SebyR/SmartMed-Dispenser-V2/Poze/20210726_211505.jpg

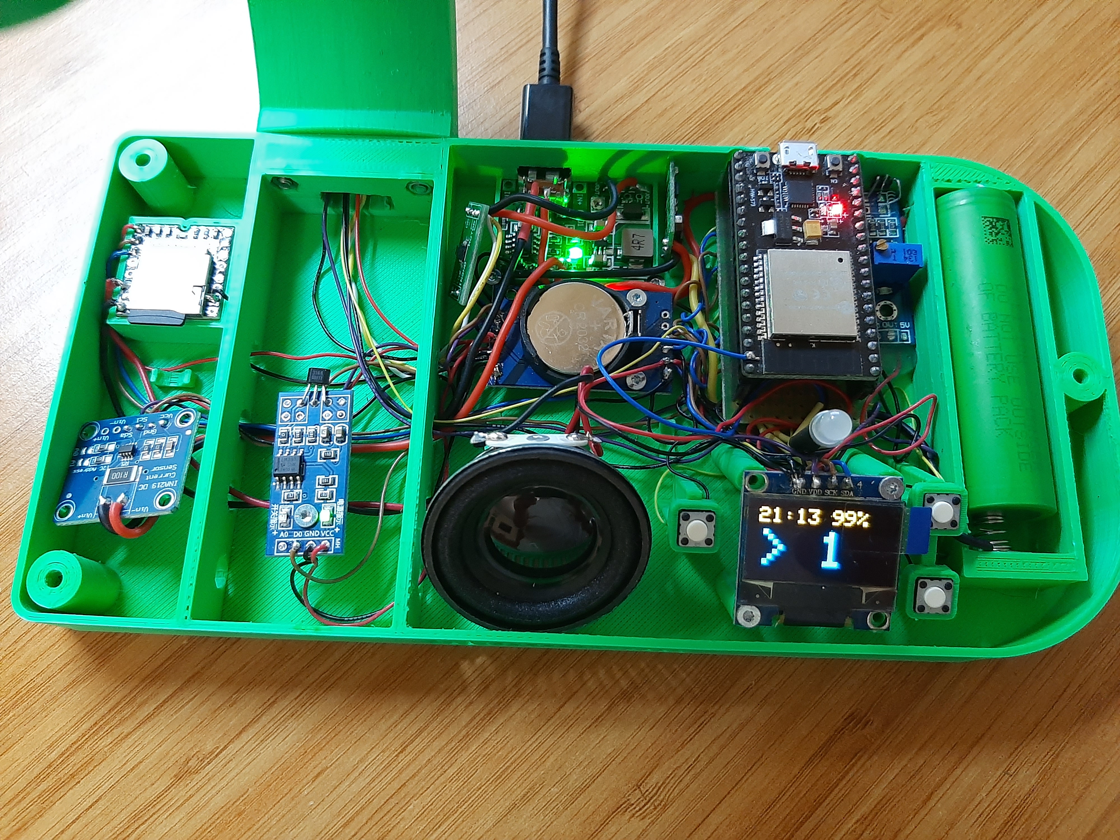
Poze/20210726_211505.jpg
