SebyR/SmartMed-Dispenser-V2/Poze/a0e3332b-9459-4f83-ae07-1069cf7968dd.jpg

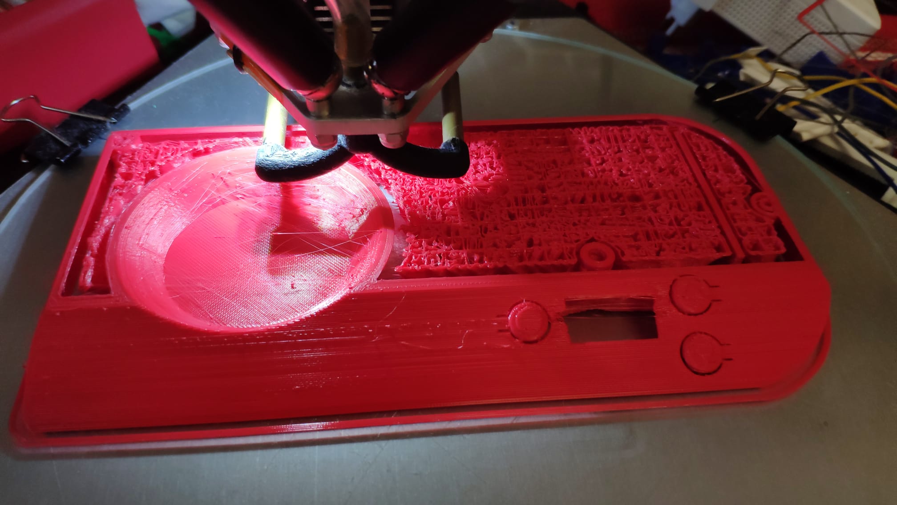
Poze/a0e3332b-9459-4f83-ae07-1069cf7968dd.jpg
