SebyR/SmartMed-Dispenser-V2/README.md

# SmartMed-Dispenser-V2
Dispozitiv inteligent programabil pentru organizarea și dozarea medicației zilnice a persoanelor în vârstă
