SebyR/SmartMed-Dispenser-V2/Poze/SmartMed_Dispenser_V2.1 v4.png

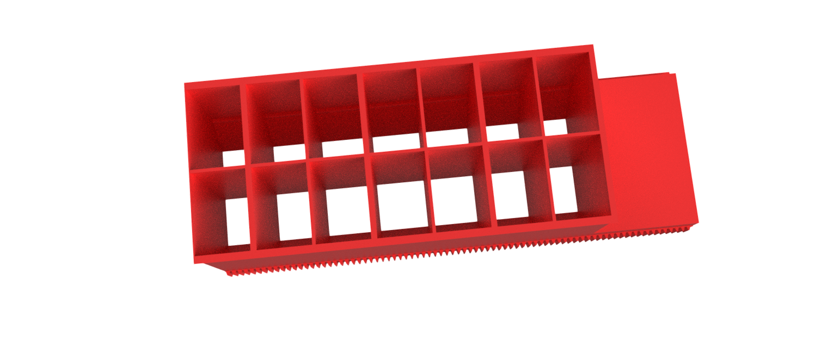
Poze/SmartMed_Dispenser_V2.1 v4.png
