SebyR/SmartMed-Dispenser-V2/STL-uri/Capac_pinion_up.stl

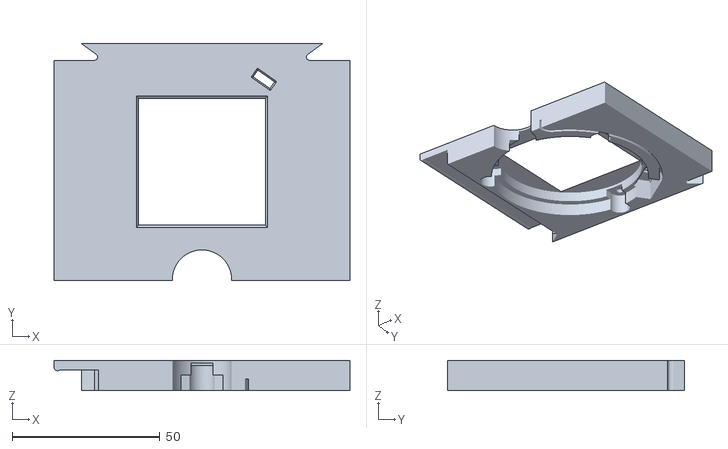
[picture p20: CAD file, 2021-07-26]
STL-uri/Capac_pinion_up.stl
100.0 x 79.9 x 10.2
