SebyR/SmartMed-Dispenser-V2/STL-uri/Capac.stl

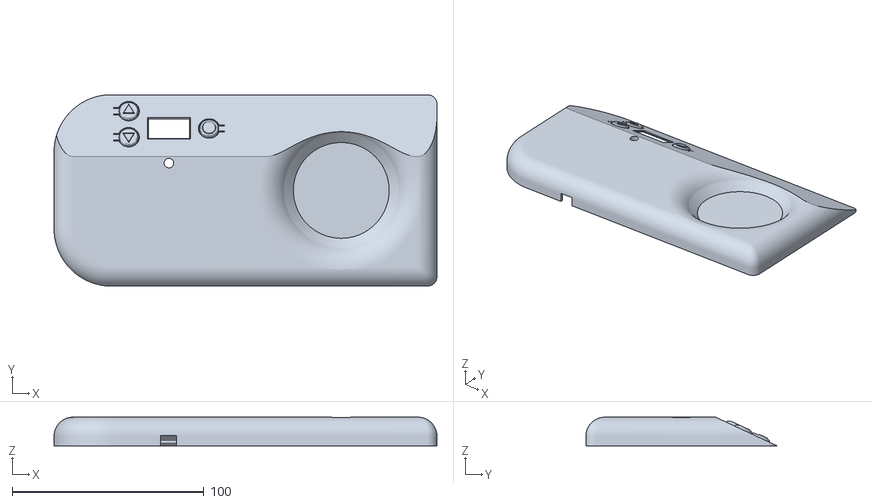
[picture p21: CAD file, 2021-07-26]
STL-uri/Capac.stl
200.0 x 99.9 x 15.0
