SebyR/SmartMed-Dispenser-V2/STL-uri/Ghidaj_fata.stl

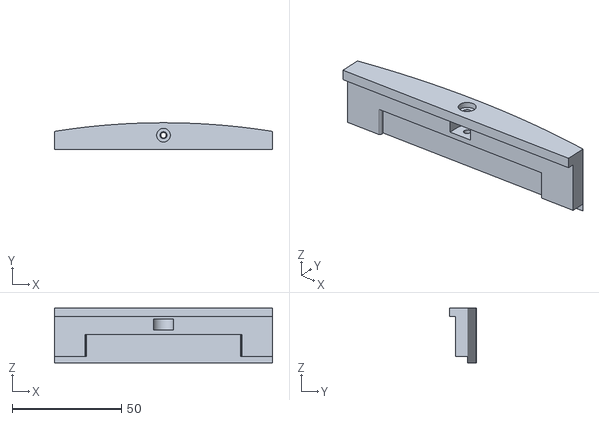
[picture p22: CAD file, 2021-07-26]
STL-uri/Ghidaj_fata.stl
100.0 x 12.2 x 25.0
