SebyR/SmartMed-Dispenser-V2/STL-uri/Brat.stl

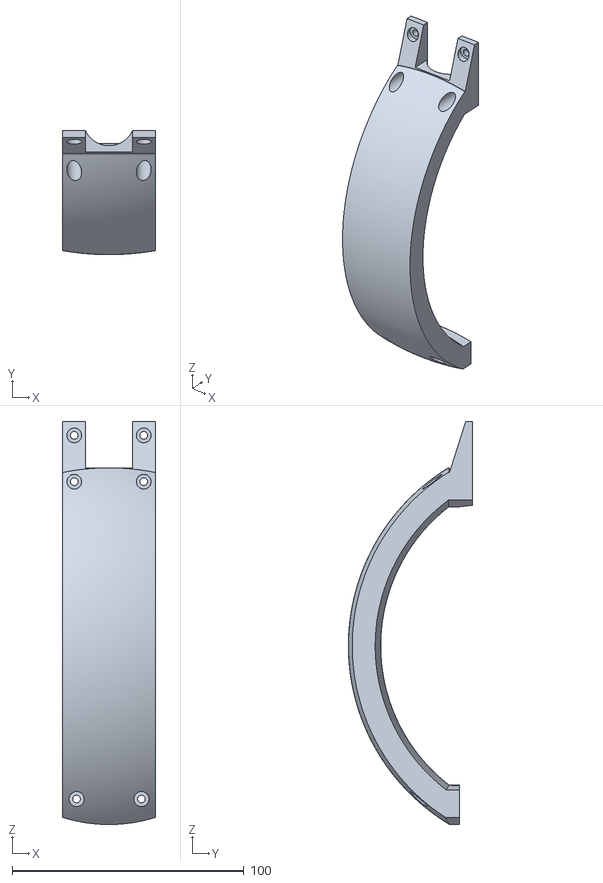
[picture p23: CAD file, 2021-07-26]
STL-uri/Brat.stl
40.0 x 53.7 x 174.0
