SebyR/SmartMed-Dispenser-V2/STL-uri/Capac_pinion_dn.stl

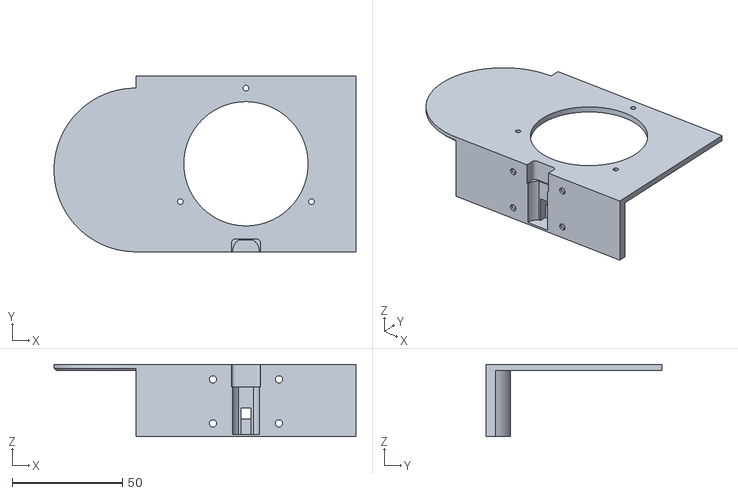
[picture p24: CAD file, 2021-07-26]
STL-uri/Capac_pinion_dn.stl
137.2 x 79.8 x 32.8
