SebyR/SmartMed-Dispenser-V2/STL-uri/Baza_disp.stl

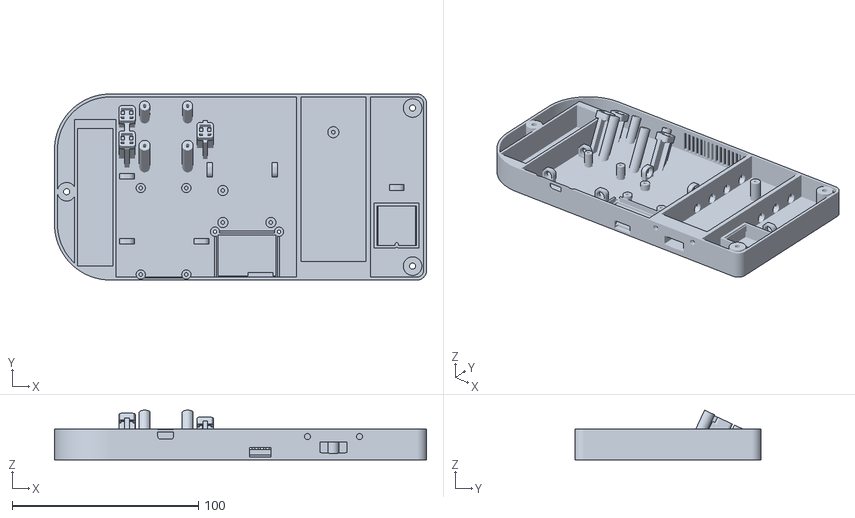
[picture p25: CAD file, 2021-07-26]
STL-uri/Baza_disp.stl
200.0 x 100.0 x 26.7
