SebyR/SmartMed-Dispenser-V2/STL-uri/Palnie.stl

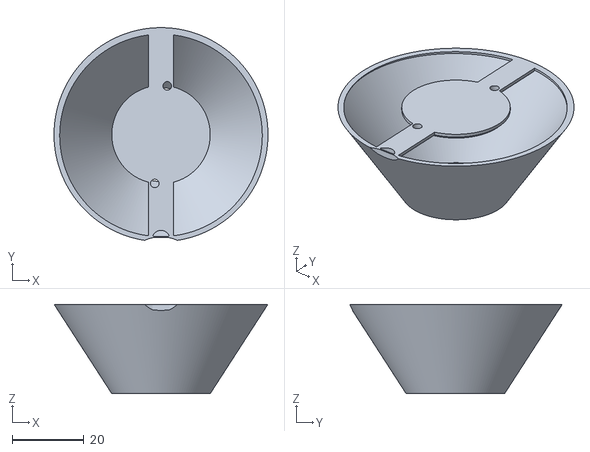
[picture p26: CAD file, 2021-07-26]
STL-uri/Palnie.stl
59.8 x 59.4 x 25.0
