SebyR/SmartMed-Dispenser-V2/STL-uri/Capac_motor.stl

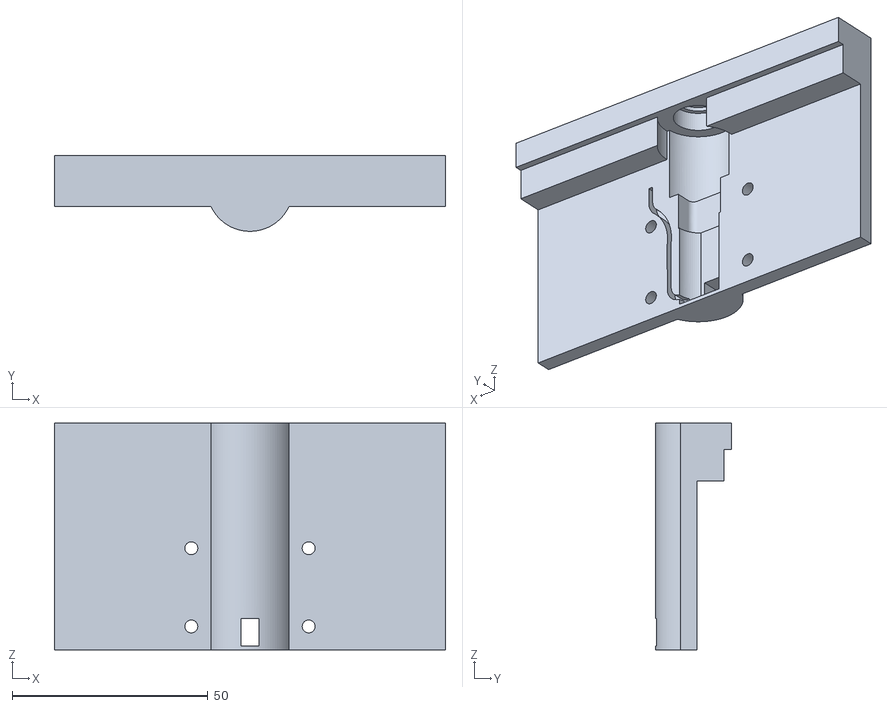
[picture p27: CAD file, 2021-07-26]
STL-uri/Capac_motor.stl
100.0 x 19.3 x 58.0
