SebyR/SmartMed-Dispenser-V2/STL-uri/Cutie_4_interv.stl

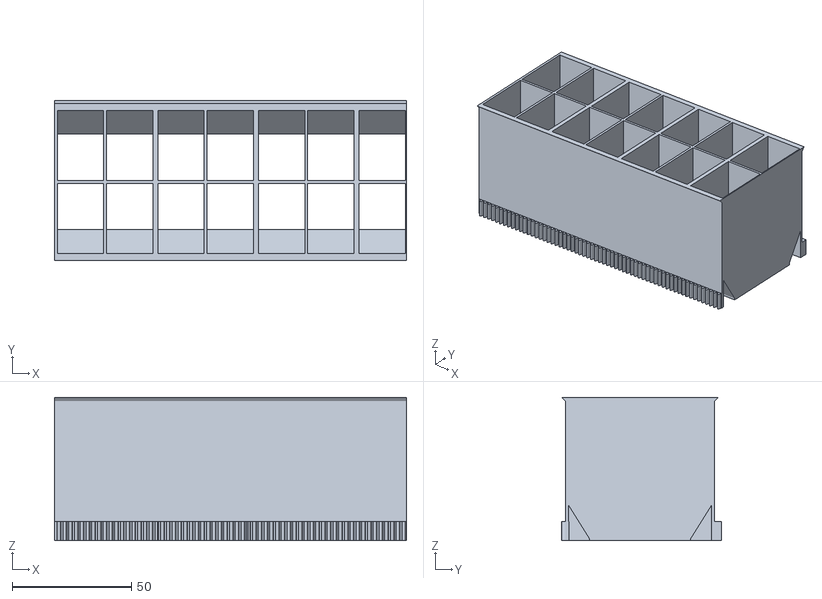
[picture p28: CAD file, 2021-07-26]
STL-uri/Cutie_4_interv.stl
147.4 x 67.2 x 60.0
