SebyR/SmartMed-Dispenser-V2/STL-uri/Capac_cutie.stl

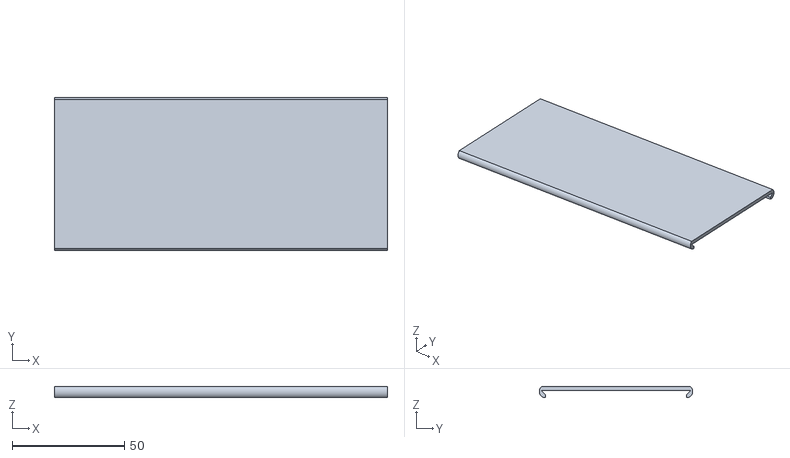
[picture p29: CAD file, 2021-07-26]
STL-uri/Capac_cutie.stl
148.3 x 68.3 x 4.89
