SebyR/SmartMed-Dispenser-V2/STL-uri/Mont_abs_pos.stl

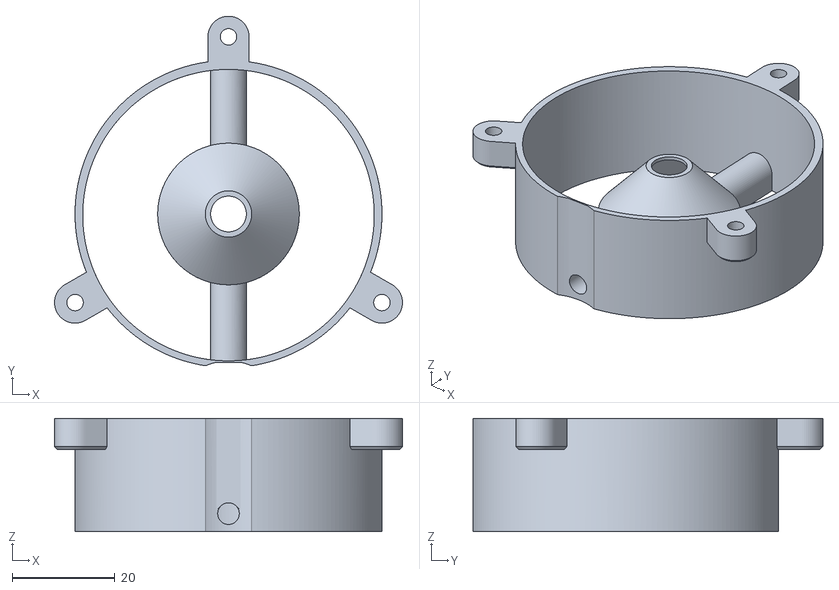
[picture p30: CAD file, 2021-07-26]
STL-uri/Mont_abs_pos.stl
67.6 x 67.9 x 22.0
