SebyR/SmartMed-Dispenser-V2/STL-uri/Suport_2.stl

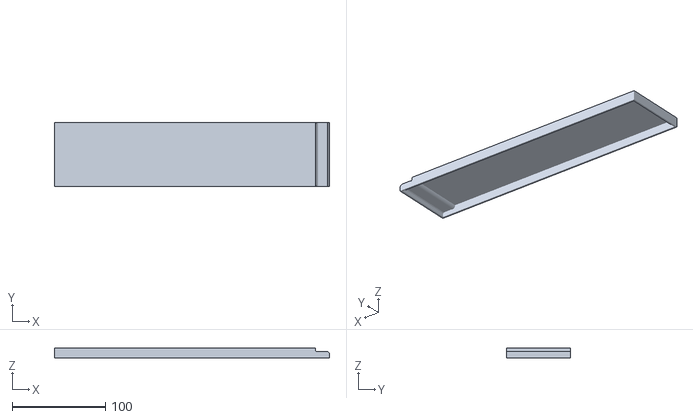
[picture p31: CAD file, 2021-07-26]
STL-uri/Suport_2.stl
294.9 x 69.0 x 10.2
