SebyR/SmartMed-Dispenser-V2/STL-uri/Bolt_magnet.stl

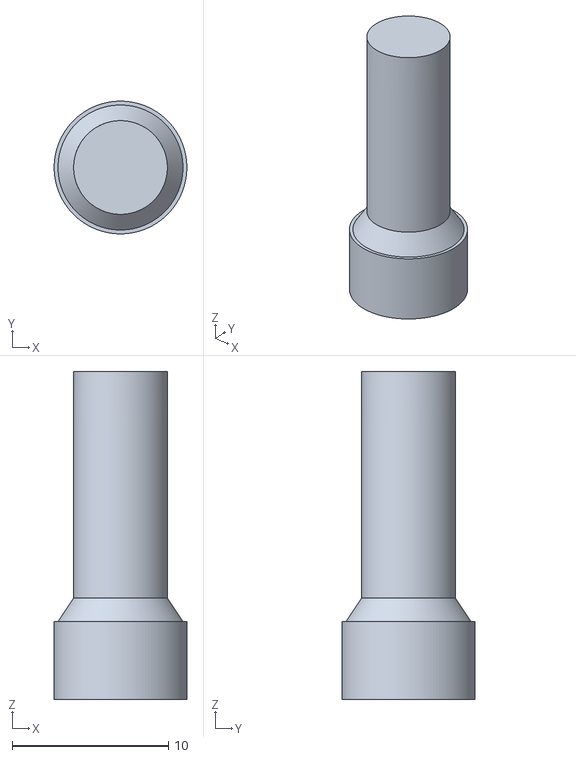
[picture p32: CAD file, 2021-07-26]
STL-uri/Bolt_magnet.stl
8.50 x 8.50 x 21.0
