SebyR/SmartMed-Dispenser-V2/STL-uri/Capac_cutie (1).stl

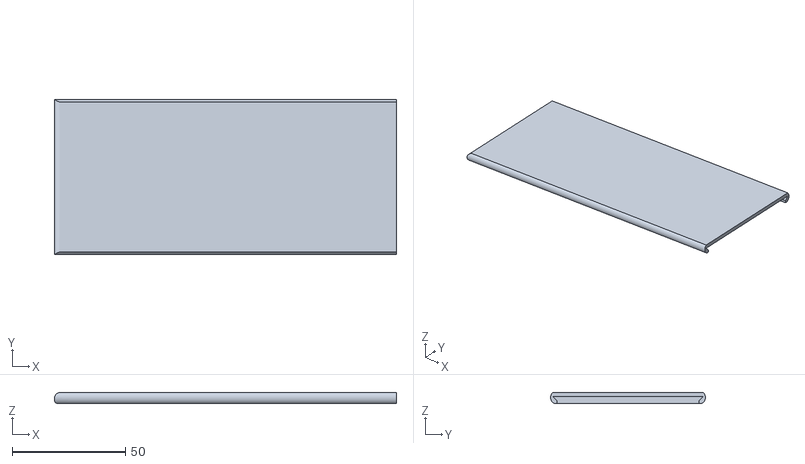
[picture p33: CAD file, 2021-07-26, an earlier design]
STL-uri/Capac_cutie (1).stl
150.8 x 68.3 x 4.89
