SebyR/SmartMed-Dispenser-V2/STL-uri/Cutie_4_interv (1).stl

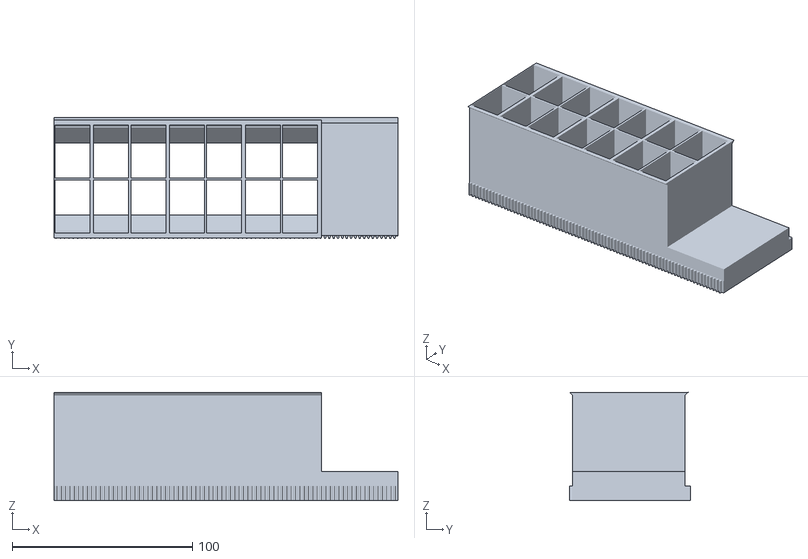
[picture p34: CAD file, 2021-07-26, an earlier design]
STL-uri/Cutie_4_interv (1).stl
190.8 x 67.2 x 60.0
